umamibeef/rp-gameboy-cartridge-hw/Readme.md

# HW repository for the Croco Cartridges
The files come as is. I used them to order the cartridges, but while ordering yourself you should of course check yourself if everything is correct.

## License
CERN Open Hardware Licence Version 2 - Permissive

## What you should look after while ordering
The PCB thickness should be 0.8mm. This will make perfect contact with the Gameboy if the PCB is within a cartridge casing.

You should order with ENIG (electroless nickel immersion gold) plating. While the cartridge will work with HASL you will getter contact with ENIG and it is less prone to wearing down.
