umamibeef/rp-gameboy-cartridge-hw/KiCad/V1/GameboyCartridgeV1.3/Schematic Croco V1.3.pdf

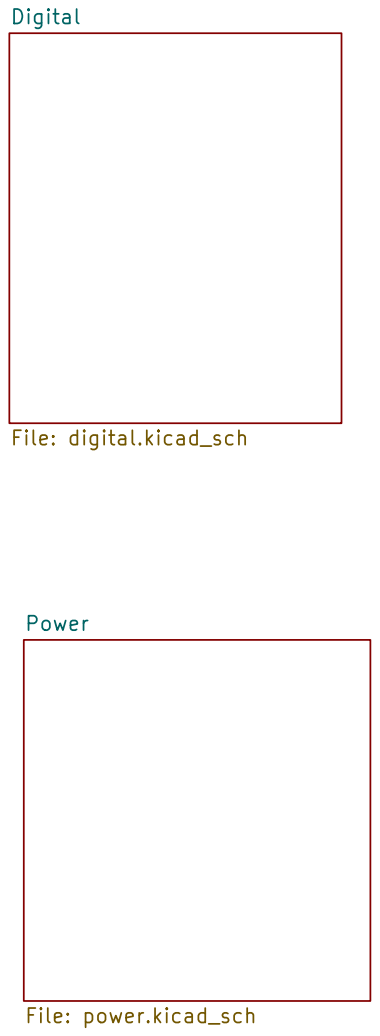
[picture p1: page 1]

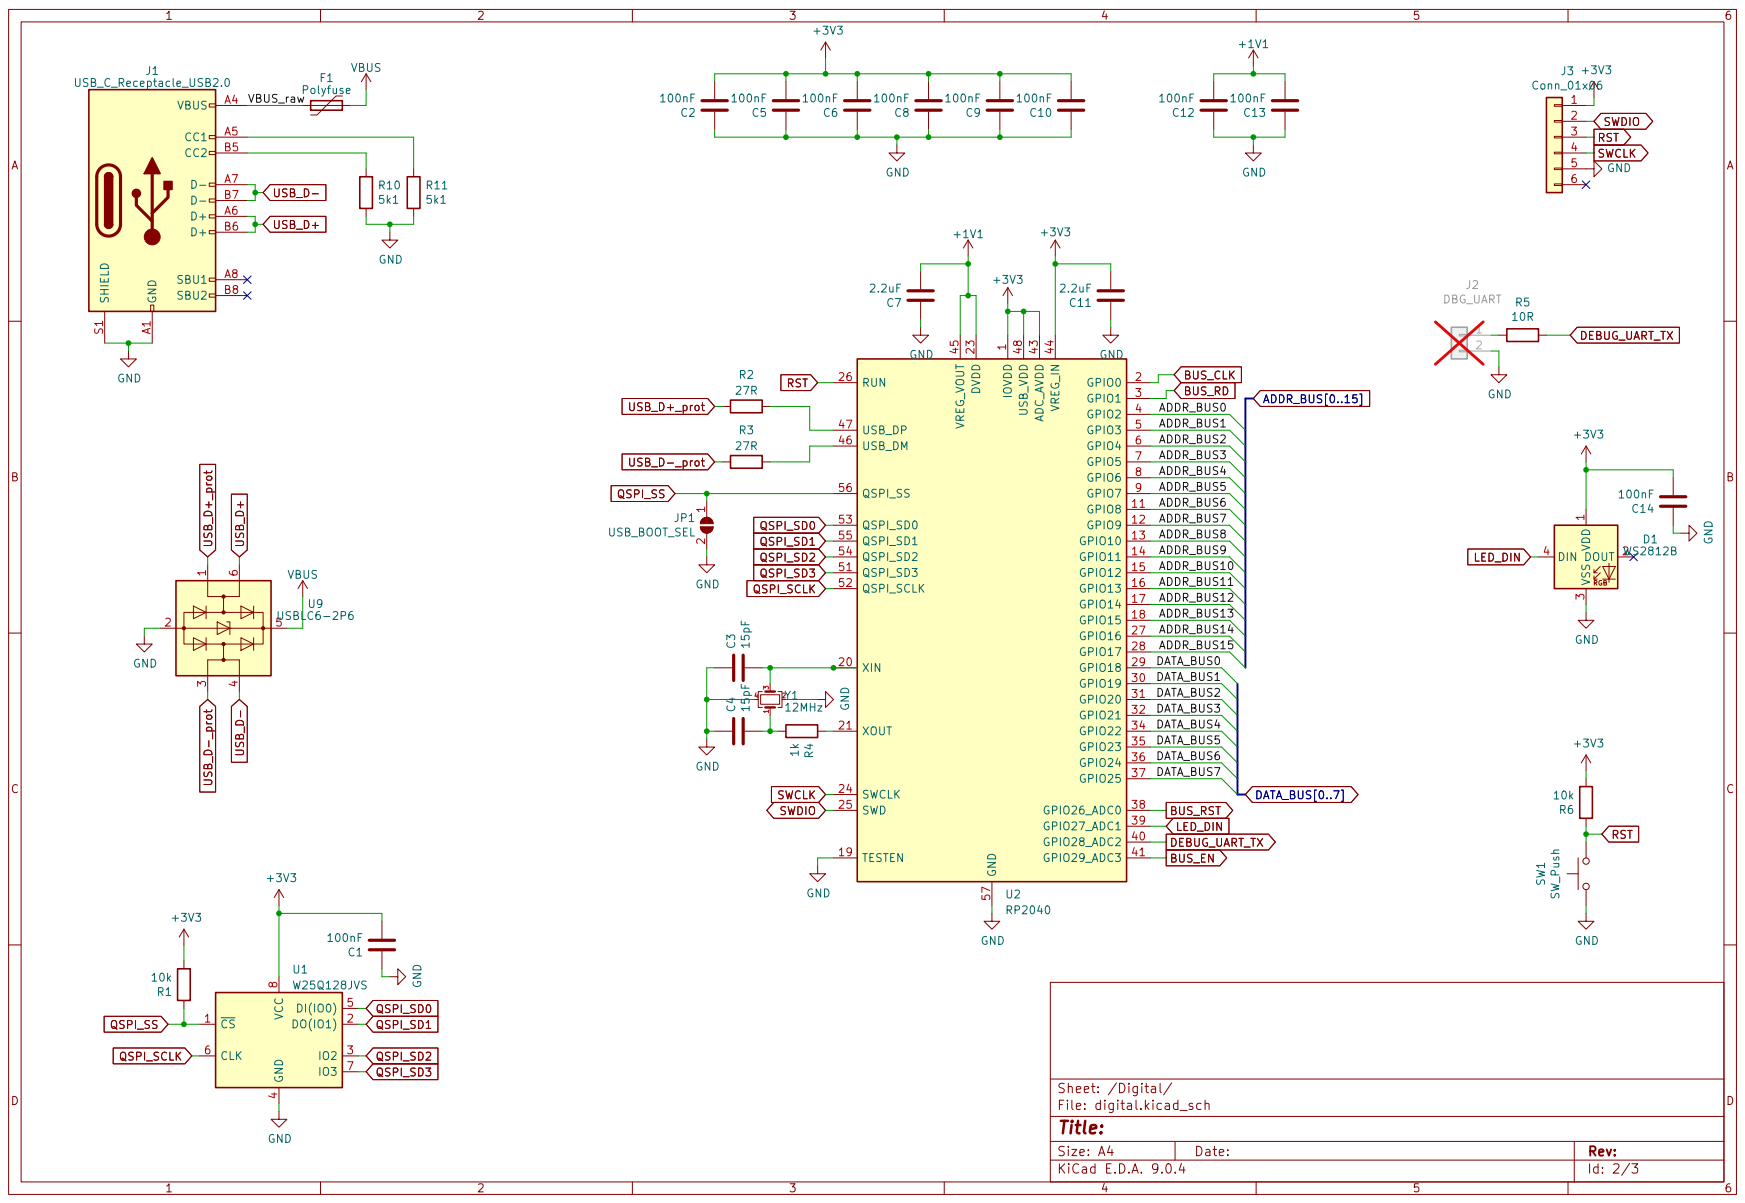
[picture p2: page 2]

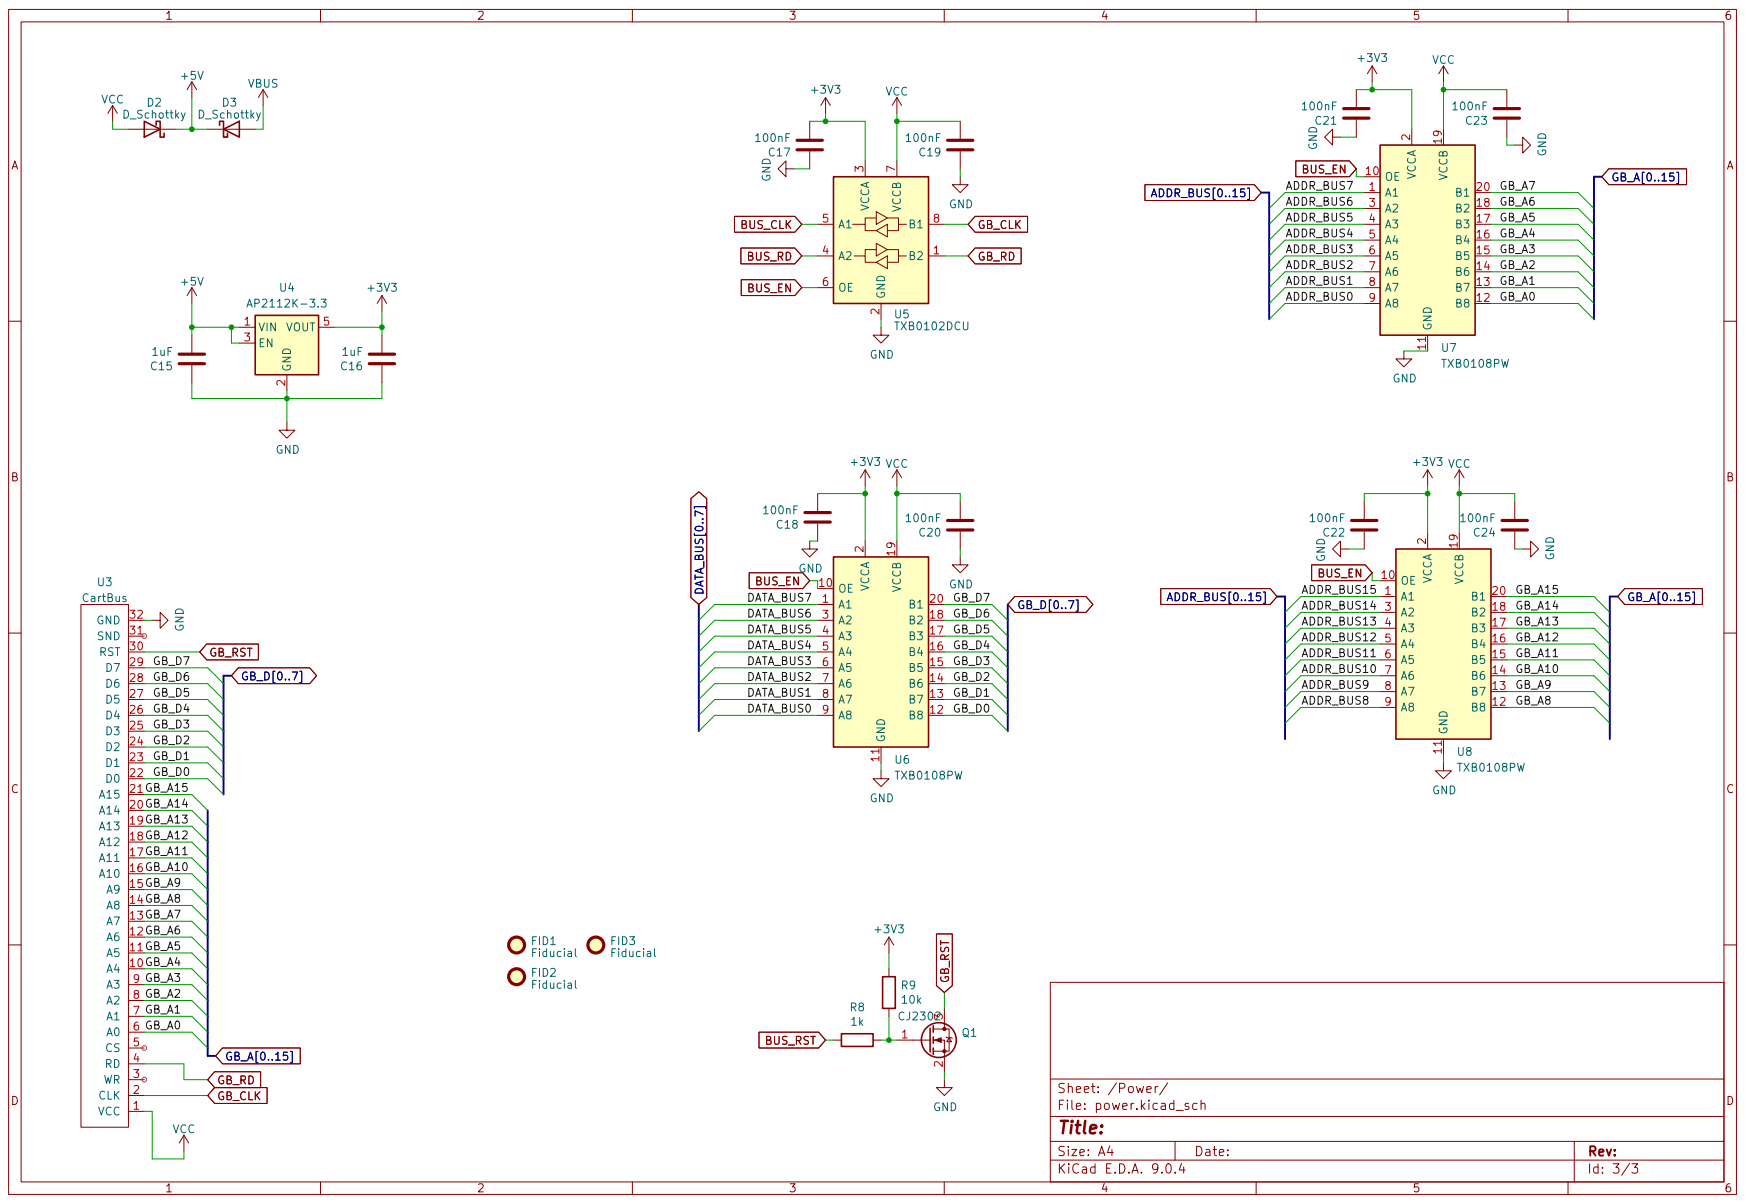
[picture p3: page 3]
