umamibeef/rp-gameboy-cartridge-hw/KiCad/V1/GameboyCartridgeV1.3/GameboyCartridgeV1.3.kicad_pcb

## KiCad design KiCad/V1/GameboyCartridgeV1.3/GameboyCartridgeV1.3.kicad_pcb (2025-11-29)

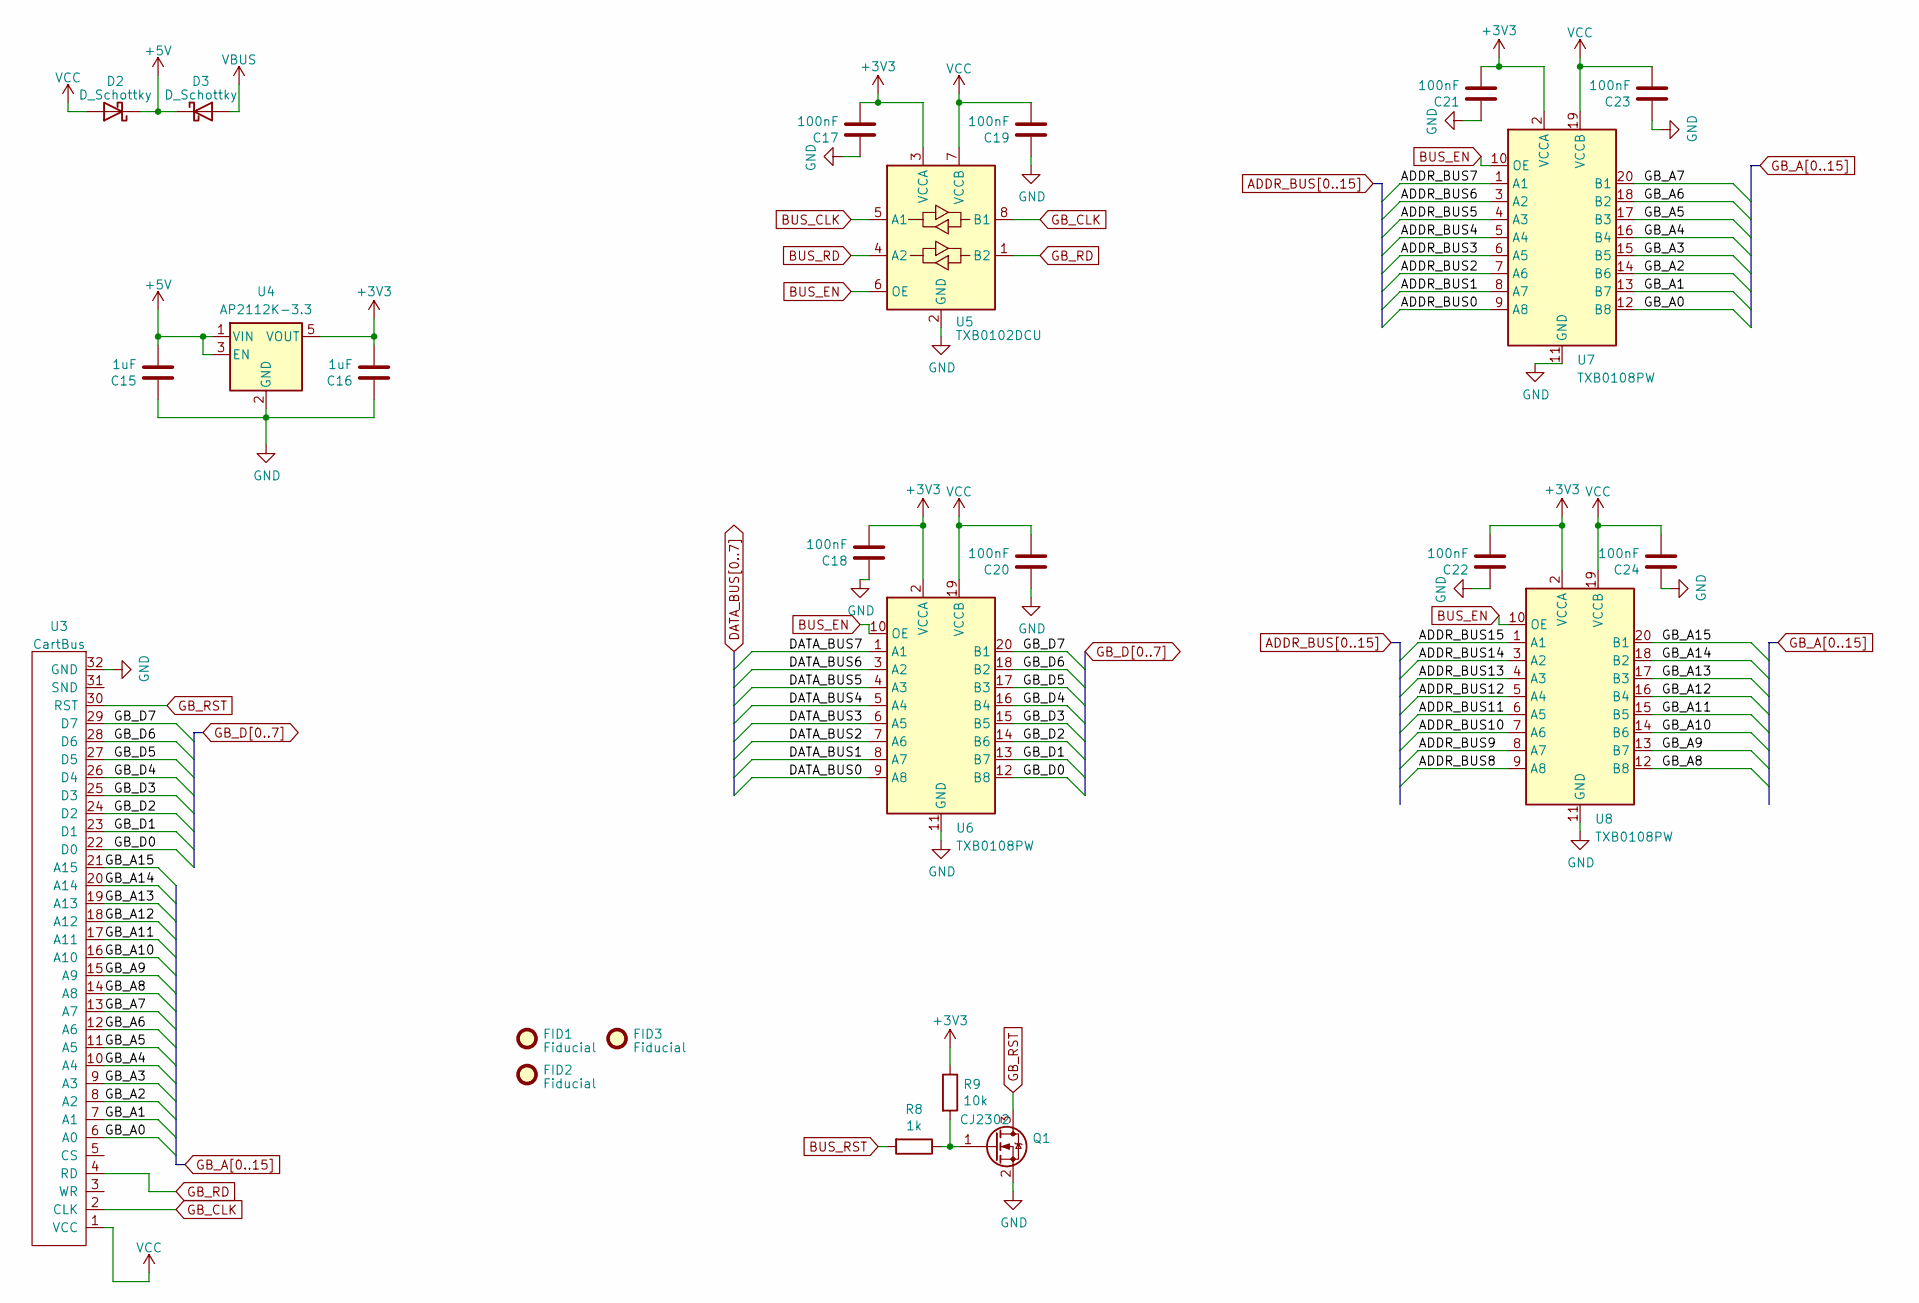
[picture p4: schematic power.kicad_sch]

Parts:
C15, C16: 1uF; C_0603_1608Metric
C17, C18, C19, C20, C21, C22, C23, C24: 100nF; C_0603_1608Metric_Pad1.08x0.95mm_HandSolder
D2, D3: D_Schottky; D_SOD-123F; LCSC C669022
FID1, FID2, FID3: Fiducial; Fiducial_1mm_Mask2mm
Q1: CJ2302; SOT-23; LCSC C8548
R8: 1k; R_0603_1608Metric_Pad0.98x0.95mm_HandSolder
R9: 10k; R_0603_1608Metric_Pad0.98x0.95mm_HandSolder
U3: CartBus; GameBoy_Cartridge_EdgeConnector
U4: AP2112K-3.3; SOT-23-5; LCSC C51118
U5: TXB0102DCU; VSSOP-8_2.4x2.1mm_P0.5mm; LCSC C60709
U6, U7, U8: TXB0108PW; TSSOP-20_4.4x6.5mm_P0.65mm; LCSC C53406

Connections:
+3V3: C16.2, C17.2, C18.2, C21.2, C22.2, R9.1, U4.5 (VOUT), U5.3 (VCCA), U6.2 (VCCA), U7.2 (VCCA), U8.2 (VCCA); also elsewhere on the board
+5V: C15.2, D2.1 (K), D3.1 (K), U4.1 (VIN), U4.3 (EN)
ADDR_BUS0: U7.9 (A8); also elsewhere on the board
ADDR_BUS1: U7.8 (A7); also elsewhere on the board
ADDR_BUS2: U7.7 (A6); also elsewhere on the board
ADDR_BUS3: U7.6 (A5); also elsewhere on the board
ADDR_BUS4: U7.5 (A4); also elsewhere on the board
ADDR_BUS5: U7.4 (A3); also elsewhere on the board
ADDR_BUS6: U7.3 (A2); also elsewhere on the board
ADDR_BUS7: U7.1 (A1); also elsewhere on the board
ADDR_BUS8: U8.9 (A8); also elsewhere on the board
ADDR_BUS9: U8.8 (A7); also elsewhere on the board
ADDR_BUS10: U8.7 (A6); also elsewhere on the board
ADDR_BUS11: U8.6 (A5); also elsewhere on the board
ADDR_BUS12: U8.5 (A4); also elsewhere on the board
ADDR_BUS13: U8.4 (A3); also elsewhere on the board
ADDR_BUS14: U8.3 (A2); also elsewhere on the board
ADDR_BUS15: U8.1 (A1); also elsewhere on the board
BUS_CLK: U5.5 (A1); also elsewhere on the board
BUS_EN: U5.6 (OE), U6.10 (OE), U7.10 (OE), U8.10 (OE); also elsewhere on the board
BUS_RD: U5.4 (A2); also elsewhere on the board
BUS_RST: R8.2; also elsewhere on the board
DATA_BUS0: U6.9 (A8); also elsewhere on the board
DATA_BUS1: U6.8 (A7); also elsewhere on the board
DATA_BUS2: U6.7 (A6); also elsewhere on the board
DATA_BUS3: U6.6 (A5); also elsewhere on the board
DATA_BUS4: U6.5 (A4); also elsewhere on the board
DATA_BUS5: U6.4 (A3); also elsewhere on the board
DATA_BUS6: U6.3 (A2); also elsewhere on the board
DATA_BUS7: U6.1 (A1); also elsewhere on the board
GB_A0: U3.6 (A0), U7.12 (B8)
GB_A1: U3.7 (A1), U7.13 (B7)
GB_A2: U3.8 (A2), U7.14 (B6)
GB_A3: U3.9 (A3), U7.15 (B5)
GB_A4: U3.10 (A4), U7.16 (B4)
GB_A5: U3.11 (A5), U7.17 (B3)
GB_A6: U3.12 (A6), U7.18 (B2)
GB_A7: U3.13 (A7), U7.20 (B1)
GB_A8: U3.14 (A8), U8.12 (B8)
GB_A9: U3.15 (A9), U8.13 (B7)
GB_A10: U3.16 (A10), U8.14 (B6)
GB_A11: U3.17 (A11), U8.15 (B5)
GB_A12: U3.18 (A12), U8.16 (B4)
GB_A13: U3.19 (A13), U8.17 (B3)
GB_A14: U3.20 (A14), U8.18 (B2)
GB_A15: U3.21 (A15), U8.20 (B1)
GB_CLK: U3.2 (CLK~), U5.8 (B1)
GB_D0: U3.22 (D0), U6.12 (B8)
GB_D1: U3.23 (D1), U6.13 (B7)
GB_D2: U3.24 (D2), U6.14 (B6)
GB_D3: U3.25 (D3), U6.15 (B5)
GB_D4: U3.26 (D4), U6.16 (B4)
GB_D5: U3.27 (D5), U6.17 (B3)
GB_D6: U3.28 (D6), U6.18 (B2)
GB_D7: U3.29 (D7), U6.20 (B1)
GB_RD: U3.4 (RD), U5.1 (B2)
GB_RST: Q1.3 (D), U3.30 (RST)
GND: C15.1, C16.1, C17.1, C18.1, C19.1, C20.1, C21.1, C22.1, C23.1, C24.1, Q1.2 (S), U3.32 (GND), U4.2 (GND), U5.2 (GND), U6.11 (GND), U7.11 (GND), U8.11 (GND); also elsewhere on the board
unnamed: Q1.1 (G), R8.1, R9.2
VBUS: D3.2 (A); also elsewhere on the board
VCC: C19.2, C20.2, C23.2, C24.2, D2.2 (A), U3.1 (VCC), U5.7 (VCCB), U6.19 (VCCB), U7.19 (VCCB), U8.19 (VCCB)

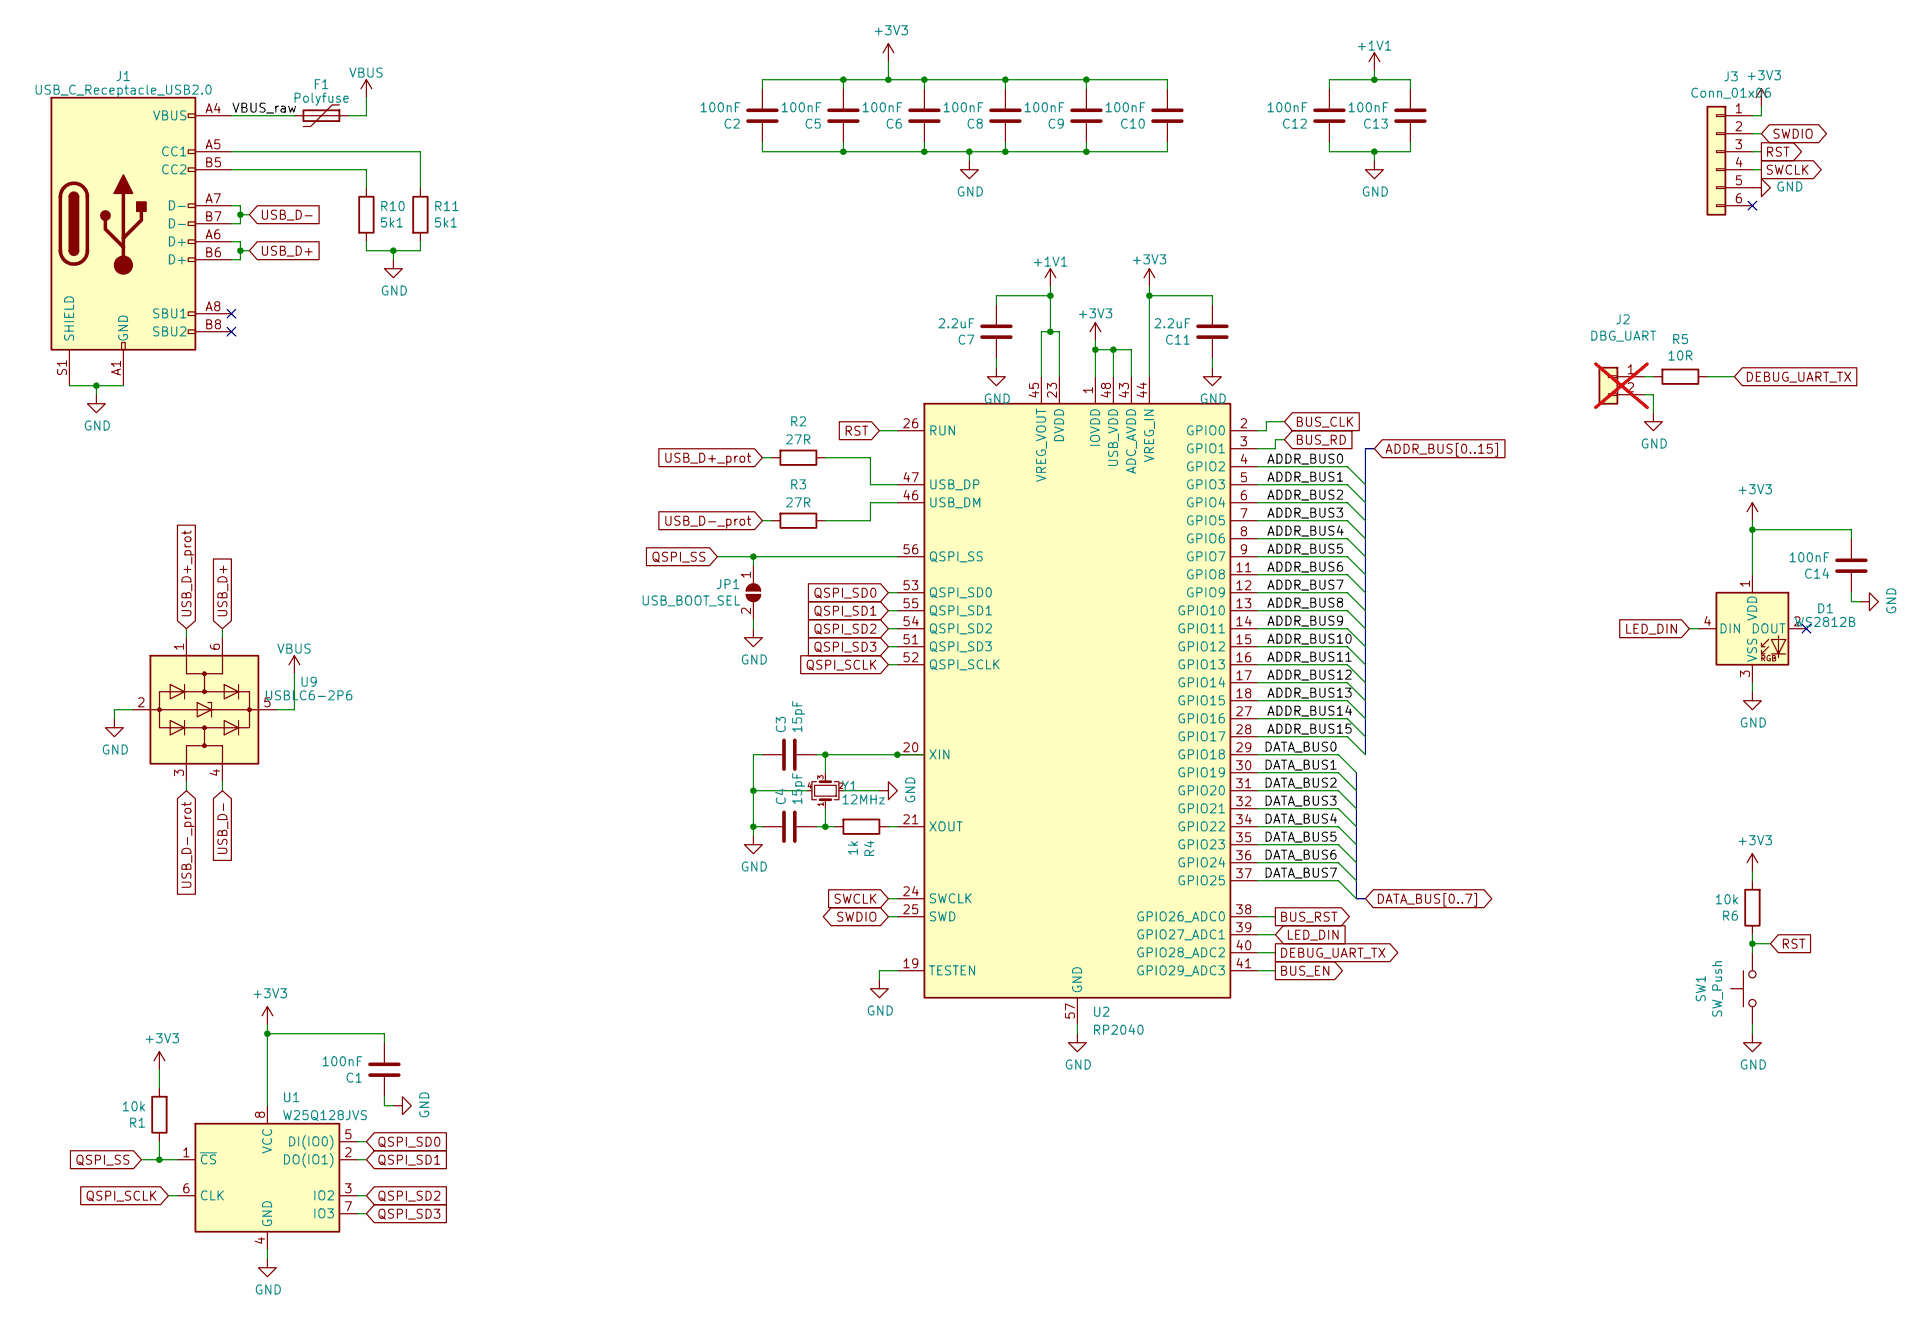
[picture p5: schematic digital.kicad_sch]

Parts:
C1, C14: 100nF; C_0603_1608Metric_Pad1.08x0.95mm_HandSolder
C2, C5, C6, C8, C9, C10, C12, C13: 100nF; C_0402_1005Metric_Pad0.74x0.62mm_HandSolder
C3, C4: 15pF; C_0603_1608Metric_Pad1.08x0.95mm_HandSolder; LCSC C1644
C7, C11: 2.2uF; C_0603_1608Metric_Pad1.08x0.95mm_HandSolder
D1: WS2812B; LED_WS2812B_PLCC4_5.0x5.0mm_P3.2mm; LCSC C2761795
F1: Polyfuse; Fuse_1206_3216Metric; LCSC C6964264
J1: USB_C_Receptacle_USB2.0; USB_C_Receptacle_GCT_USB4105-xx-A_16P_TopMnt_Horizontal; LCSC C2927037
J2: DBG_UART; PinHeader_1x02_P2.54mm_Horizontal; not fitted
J3: Conn_01x06; Tag-Connect_TC2030-IDC-FP_2x03_P1.27mm_Vertical
JP1: USB_BOOT_SEL; SolderJumper-2_P1.3mm_Open_RoundedPad1.0x1.5mm
R1, R6: 10k; R_0603_1608Metric_Pad0.98x0.95mm_HandSolder
R2, R3: 27R; R_0603_1608Metric_Pad0.98x0.95mm_HandSolder
R4: 1k; R_0603_1608Metric_Pad0.98x0.95mm_HandSolder
R5: 10R; R_0603_1608Metric_Pad0.98x0.95mm_HandSolder
R10, R11: 5k1; R_0603_1608Metric_Pad0.98x0.95mm_HandSolder
SW1: SW_Push; SW_SPST_TL3342; LCSC C2886898
U1: W25Q128JVS; SOIC-8_5.23x5.23mm_P1.27mm; LCSC C97521
U2: RP2040; QFN-56-1EP_7x7mm_P0.4mm_EP3.2x3.2mm; LCSC C2040
U9: USBLC6-2P6; SOT-666; LCSC C15999
Y1: 12MHz; Crystal_SMD_TXC_7M-4Pin_3.2x2.5mm; LCSC C668845

Connections:
+1V1: C7.2, C12.2, C13.2, U2.23 (DVDD), U2.45 (VREG_VOUT), U2.50 (DVDD)
+3V3: C1.2, C2.2, C5.2, C6.2, C8.2, C9.2, C10.2, C11.2, C14.2, D1.1 (VDD), J3.1, R1.2, R6.2, U1.8 (VCC), U2.1 (IOVDD), U2.10 (IOVDD), U2.22 (IOVDD), U2.33 (IOVDD), U2.42 (IOVDD), U2.43 (ADC_AVDD), U2.44 (VREG_IN), U2.48 (USB_VDD), U2.49 (IOVDD); also elsewhere on the board
/Digital/VBUS_raw: F1.2, J1.A4 (VBUS), J1.A9 (VBUS), J1.B4 (VBUS), J1.B9 (VBUS)
ADDR_BUS0: U2.4 (GPIO2); also elsewhere on the board
ADDR_BUS1: U2.5 (GPIO3); also elsewhere on the board
ADDR_BUS2: U2.6 (GPIO4); also elsewhere on the board
ADDR_BUS3: U2.7 (GPIO5); also elsewhere on the board
ADDR_BUS4: U2.8 (GPIO6); also elsewhere on the board
ADDR_BUS5: U2.9 (GPIO7); also elsewhere on the board
ADDR_BUS6: U2.11 (GPIO8); also elsewhere on the board
ADDR_BUS7: U2.12 (GPIO9); also elsewhere on the board
ADDR_BUS8: U2.13 (GPIO10); also elsewhere on the board
ADDR_BUS9: U2.14 (GPIO11); also elsewhere on the board
ADDR_BUS10: U2.15 (GPIO12); also elsewhere on the board
ADDR_BUS11: U2.16 (GPIO13); also elsewhere on the board
ADDR_BUS12: U2.17 (GPIO14); also elsewhere on the board
ADDR_BUS13: U2.18 (GPIO15); also elsewhere on the board
ADDR_BUS14: U2.27 (GPIO16); also elsewhere on the board
ADDR_BUS15: U2.28 (GPIO17); also elsewhere on the board
BUS_CLK: U2.2 (GPIO0); also elsewhere on the board
BUS_EN: U2.41 (GPIO29_ADC3); also elsewhere on the board
BUS_RD: U2.3 (GPIO1); also elsewhere on the board
BUS_RST: U2.38 (GPIO26_ADC0); also elsewhere on the board
DATA_BUS0: U2.29 (GPIO18); also elsewhere on the board
DATA_BUS1: U2.30 (GPIO19); also elsewhere on the board
DATA_BUS2: U2.31 (GPIO20); also elsewhere on the board
DATA_BUS3: U2.32 (GPIO21); also elsewhere on the board
DATA_BUS4: U2.34 (GPIO22); also elsewhere on the board
DATA_BUS5: U2.35 (GPIO23); also elsewhere on the board
DATA_BUS6: U2.36 (GPIO24); also elsewhere on the board
DATA_BUS7: U2.37 (GPIO25); also elsewhere on the board
DEBUG_UART_TX: R5.1, U2.40 (GPIO28_ADC2)
GND: C1.1, C2.1, C3.1, C4.1, C5.1, C6.1, C7.1, C8.1, C9.1, C10.1, C11.1, C12.1, C13.1, C14.1, D1.3 (VSS), J1.A1 (GND), J1.A12 (GND), J1.B1 (GND), J1.B12 (GND), J1.S1 (SHIELD), J2.2, J3.5, JP1.2 (B), R10.2, R11.2, SW1.2, U1.4 (GND), U2.19 (TESTEN), U2.57 (GND), U9.2 (GND), Y1.2, Y1.4; also elsewhere on the board
LED_DIN: D1.4 (DIN), U2.39 (GPIO27_ADC1)
unnamed: C4.2, R4.2, Y1.1
unnamed: J1.A5 (CC1), R11.1
unnamed: J1.B5 (CC2), R10.1
unnamed: J2.1, R5.2
unnamed: R3.1, U2.46 (USB_DM)
unnamed: R2.1, U2.47 (USB_DP)
unnamed: C3.2, U2.20 (XIN), Y1.3
unnamed: R4.1, U2.21 (XOUT)
QSPI_SCLK: U1.6 (CLK), U2.52 (QSPI_SCLK)
QSPI_SD0: U1.5 (DI(IO0)), U2.53 (QSPI_SD0)
QSPI_SD1: U1.2 (DO(IO1)), U2.55 (QSPI_SD1)
QSPI_SD2: U1.3 (IO2), U2.54 (QSPI_SD2)
QSPI_SD3: U1.7 (IO3), U2.51 (QSPI_SD3)
QSPI_SS: JP1.1 (A), R1.1, U1.1 (~CS), U2.56 (QSPI_SS)
RST: J3.3, R6.1, SW1.1, U2.26 (RUN)
SWCLK: J3.4, U2.24 (SWCLK)
SWDIO: J3.2, U2.25 (SWD)
USB_D+: J1.A6 (D+), J1.B6 (D+), U9.6 (I/O1)
USB_D+_prot: R2.2, U9.1 (I/O1)
USB_D-: J1.A7 (D-), J1.B7 (D-), U9.4 (I/O2)
USB_D-_prot: R3.2, U9.3 (I/O2)
VBUS: F1.1, U9.5 (VBUS); also elsewhere on the board

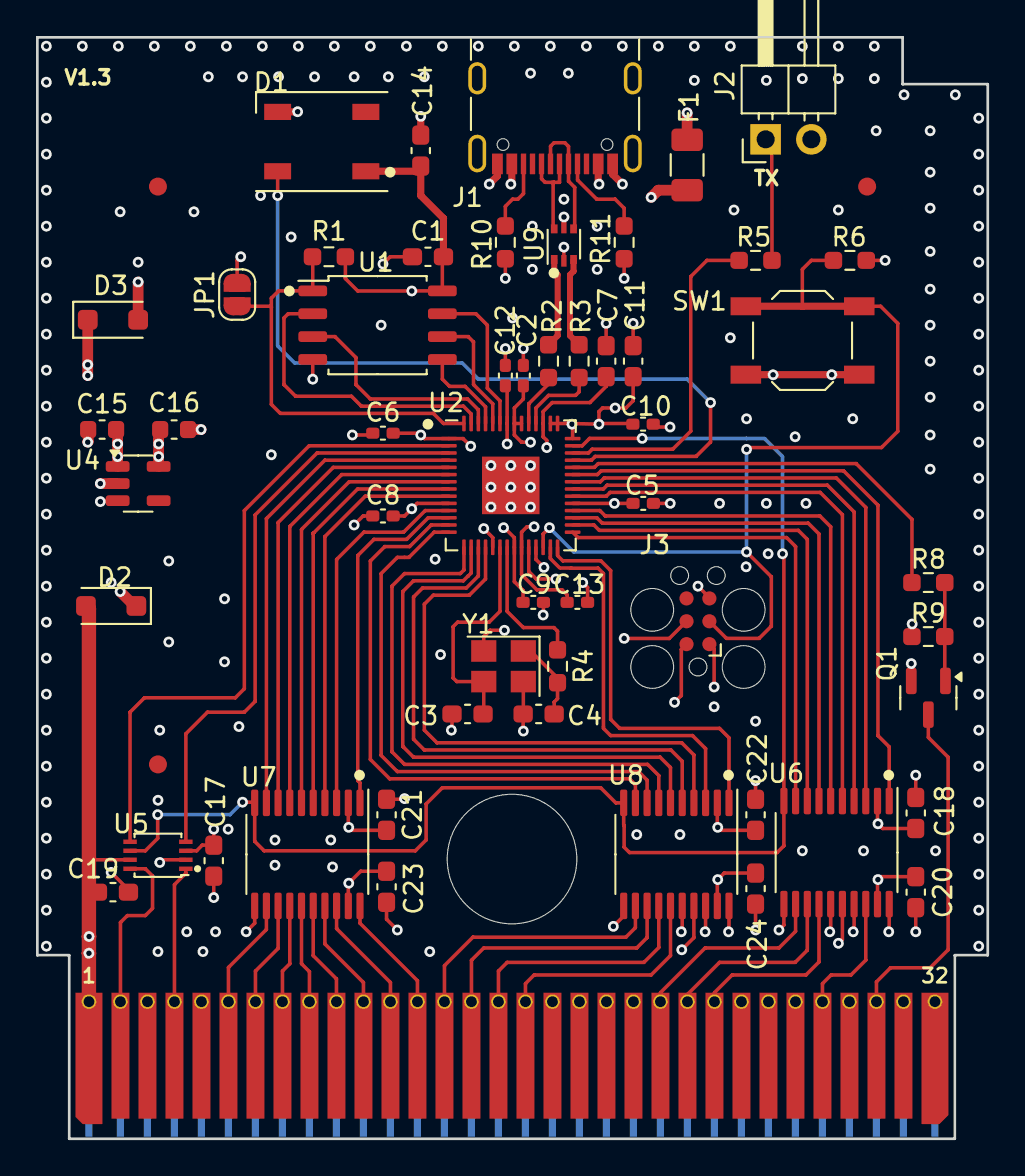
[picture p6: board GameboyCartridgeV1.3.kicad_pcb from above]

Board: 4 copper layers, 52.8 x 61.2 mm, 57 parts (0 on the bottom side), 86 nets.
